chaosdorf/projector-controller-iot/README.md

# Chaosdorf Projector IOT

A simple IOT device to control our projector over serial. WIP.
