chaosdorf/projector-controller-iot/bracket/bracket.FCStd

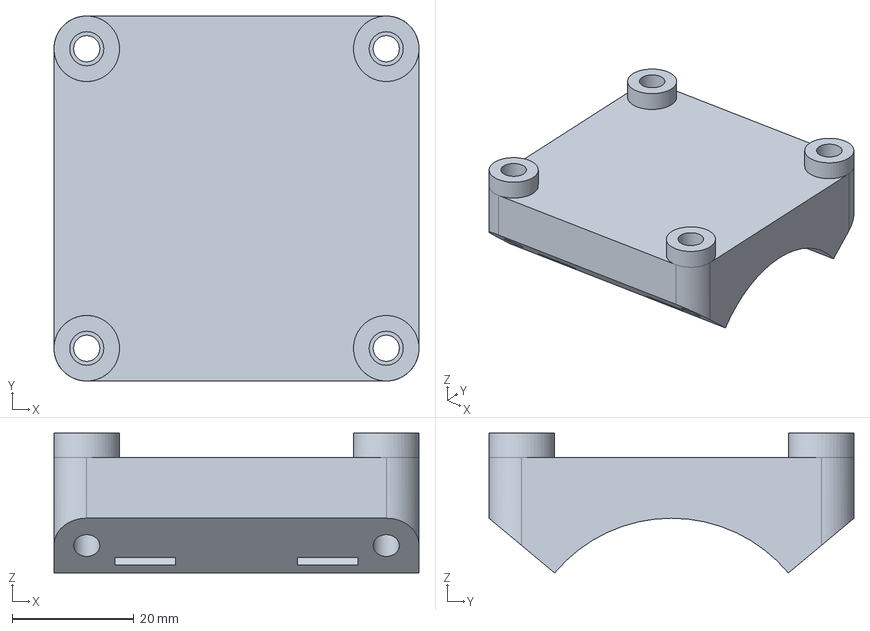
[picture p1: CAD file, 2025-09-13]
bracket/bracket.FCStd
60.0 x 60.0 x 23.0 mm
