chaosdorf/projector-controller-iot/(list of files, cad)

Other CAD files:
bracket/projector bracket.FCStd
bracket/bracket-bracket.step
bracket/bracket-bracket.stl
