chaosdorf/projector-controller-iot/pcb/projector-controller-iot.kicad_pcb

## KiCad design pcb/projector-controller-iot.kicad_pcb (2025-09-13)

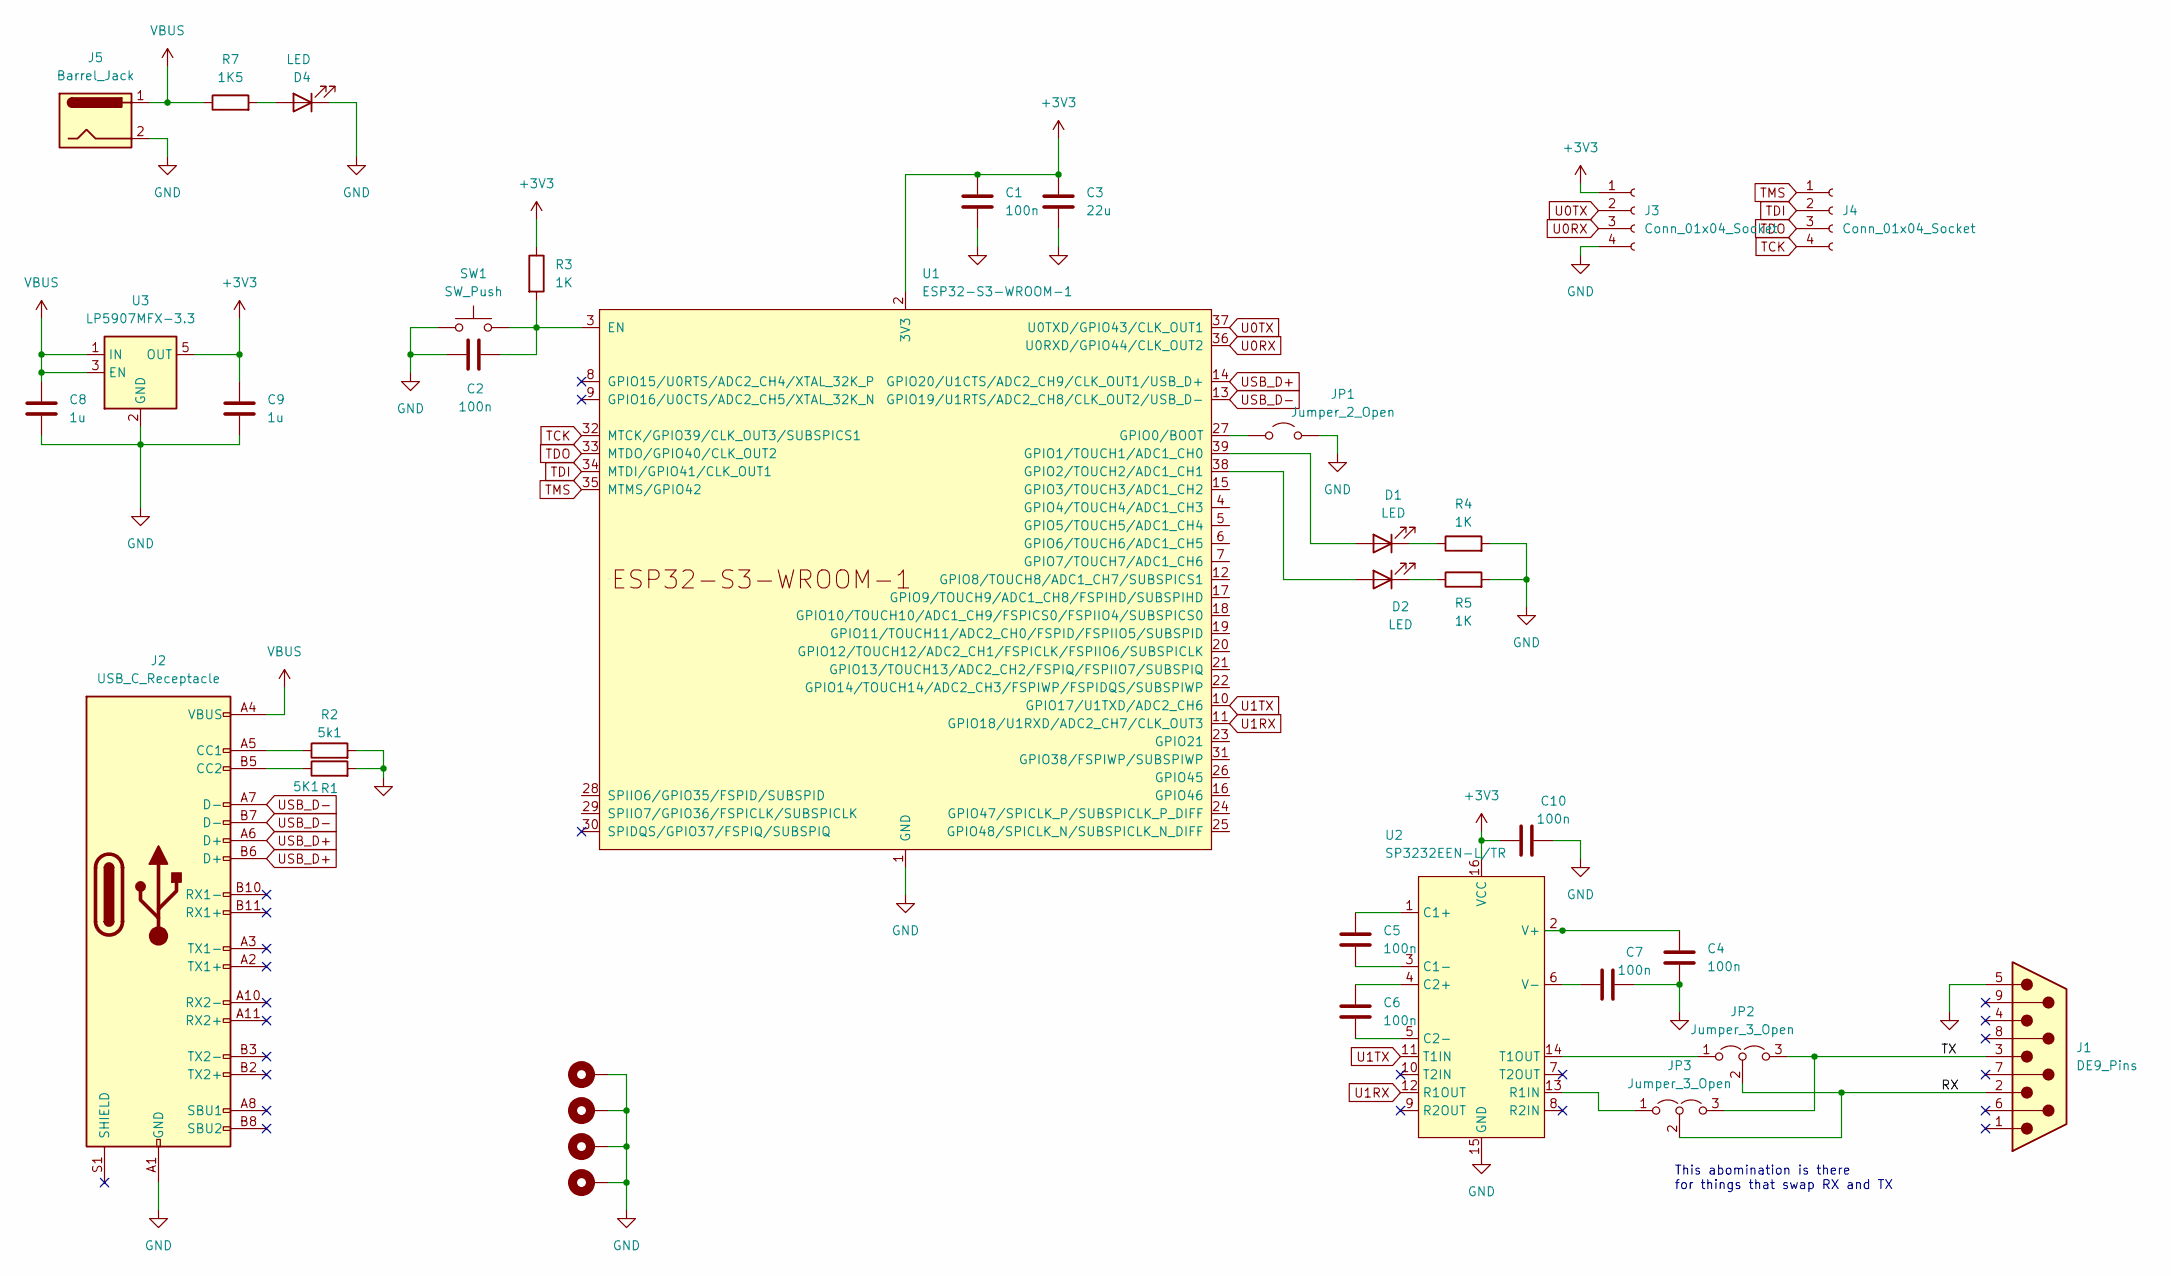
[picture p3: schematic projector-controller-iot.kicad_sch]

Parts:
C1, C2, C4, C5, C6, C7, C10: 100n; C_0603_1608Metric_Pad1.08x0.95mm_HandSolder
C3: 22u; C_0603_1608Metric_Pad1.08x0.95mm_HandSolder
C8, C9: 1u; C_0603_1608Metric_Pad1.08x0.95mm_HandSolder
D1, D2, D4: LED; LED_0603_1608Metric_Pad1.05x0.95mm_HandSolder_Triangle
H1, H2, H3, H4: MountingHole_Pad; MountingHole_4.5mm_Pad_Via
J1: DE9_Pins; DB9-TH_LD09P33E4GV00LF
J2: USB_C_Receptacle; USB_C_Receptacle_HRO_TYPE-C-31-M-12
J3, J4: Conn_01x04_Socket; JST_XH_B4B-XH-AM_1x04_P2.50mm_Vertical
J5: Barrel_Jack; DC-IN-TH_DC005
JP1: Jumper_2_Open; PinHeader_1x02_P2.54mm_Vertical
JP2, JP3: Jumper_3_Open
R1: 5K1; R_0603_1608Metric_Pad0.98x0.95mm_HandSolder
R2: 5k1; R_0603_1608Metric_Pad0.98x0.95mm_HandSolder
R3, R4, R5: 1K; R_0603_1608Metric_Pad0.98x0.95mm_HandSolder
R7: 1K5; R_0603_1608Metric_Pad0.98x0.95mm_HandSolder
SW1: SW_Push; SW-SMD_4P-L5.1-W5.1-P3.70-LS6.5-TL_H1.5
U1: ESP32-S3-WROOM-1
U2: SP3232EEN-L/TR; JEITA_SOIC-16_3.9x9.9mm_P1.27mm; LCSC Part C9378
U3: LP5907MFX-3.3; SOT-23-5

Connections:
+3V3: C1.1, C3.1, C9.1, C10.1, J3.1, R3.1, U1.2 (3V3), U2.16 (VCC), U3.5 (OUT)
/RX: J1.2, JP2.2 (C), JP3.1 (A), JP3.2 (C), U2.13 (R1IN)
/TX: J1.3, JP2.1 (A), JP2.3 (B), JP3.3 (B), U2.14 (T1OUT)
GND: C1.2, C2.1, C3.2, C4.2, C7.1, C8.2, C9.2, C10.2, D4.1 (K), H1.1, H2.1, H3.1, H4.1, J1.5, J2.A1 (GND), J2.A12 (GND), J2.B1 (GND), J2.B12 (GND), J3.4, J5.2, JP1.2 (B), R1.2, R2.2, R4.2, R5.2, SW1.1, U1.1 (GND), U1.40 (GND), U1.41 (GND), U2.15 (GND), U3.2 (GND)
unnamed: D1.2 (A), U1.39 (GPIO1/TOUCH1/ADC1_CH0)
unnamed: D1.1 (K), R4.1
unnamed: D2.2 (A), U1.38 (GPIO2/TOUCH2/ADC1_CH1)
unnamed: D2.1 (K), R5.1
unnamed: D4.2 (A), R7.2
unnamed: J2.A5 (CC1), R2.1
unnamed: J2.B5 (CC2), R1.1
unnamed: JP1.1 (A), U1.27 (GPIO0/BOOT)
unnamed: C2.2, R3.2, SW1.2, U1.3 (EN)
unnamed: C5.1, U2.1 (C1+)
unnamed: C5.2, U2.3 (C1-)
unnamed: C6.1, U2.4 (C2+)
unnamed: C6.2, U2.5 (C2-)
unnamed: C4.1, U2.2 (V+)
unnamed: C7.2, U2.6 (V-)
TCK: J4.4, U1.32 (MTCK/GPIO39/CLK_OUT3/SUBSPICS1)
TDI: J4.2, U1.34 (MTDI/GPIO41/CLK_OUT1)
TDO: J4.3, U1.33 (MTDO/GPIO40/CLK_OUT2)
TMS: J4.1, U1.35 (MTMS/GPIO42)
U0RX: J3.3, U1.36 (U0RXD/GPIO44/CLK_OUT2)
U0TX: J3.2, U1.37 (U0TXD/GPIO43/CLK_OUT1)
U1RX: U1.11 (GPIO18/U1RXD/ADC2_CH7/CLK_OUT3), U2.12 (R1OUT)
U1TX: U1.10 (GPIO17/U1TXD/ADC2_CH6), U2.11 (T1IN)
USB_D+: J2.A6 (D+), J2.B6 (D+), U1.14 (GPIO20/U1CTS/ADC2_CH9/CLK_OUT1/USB_D+)
USB_D-: J2.A7 (D-), J2.B7 (D-), U1.13 (GPIO19/U1RTS/ADC2_CH8/CLK_OUT2/USB_D-)
VBUS: C8.1, J2.A4 (VBUS), J2.A9 (VBUS), J2.B4 (VBUS), J2.B9 (VBUS), J5.1, R7.1, U3.1 (IN), U3.3 (EN)

Notes on the sheet:
This abomination is there for things that swap RX and TX

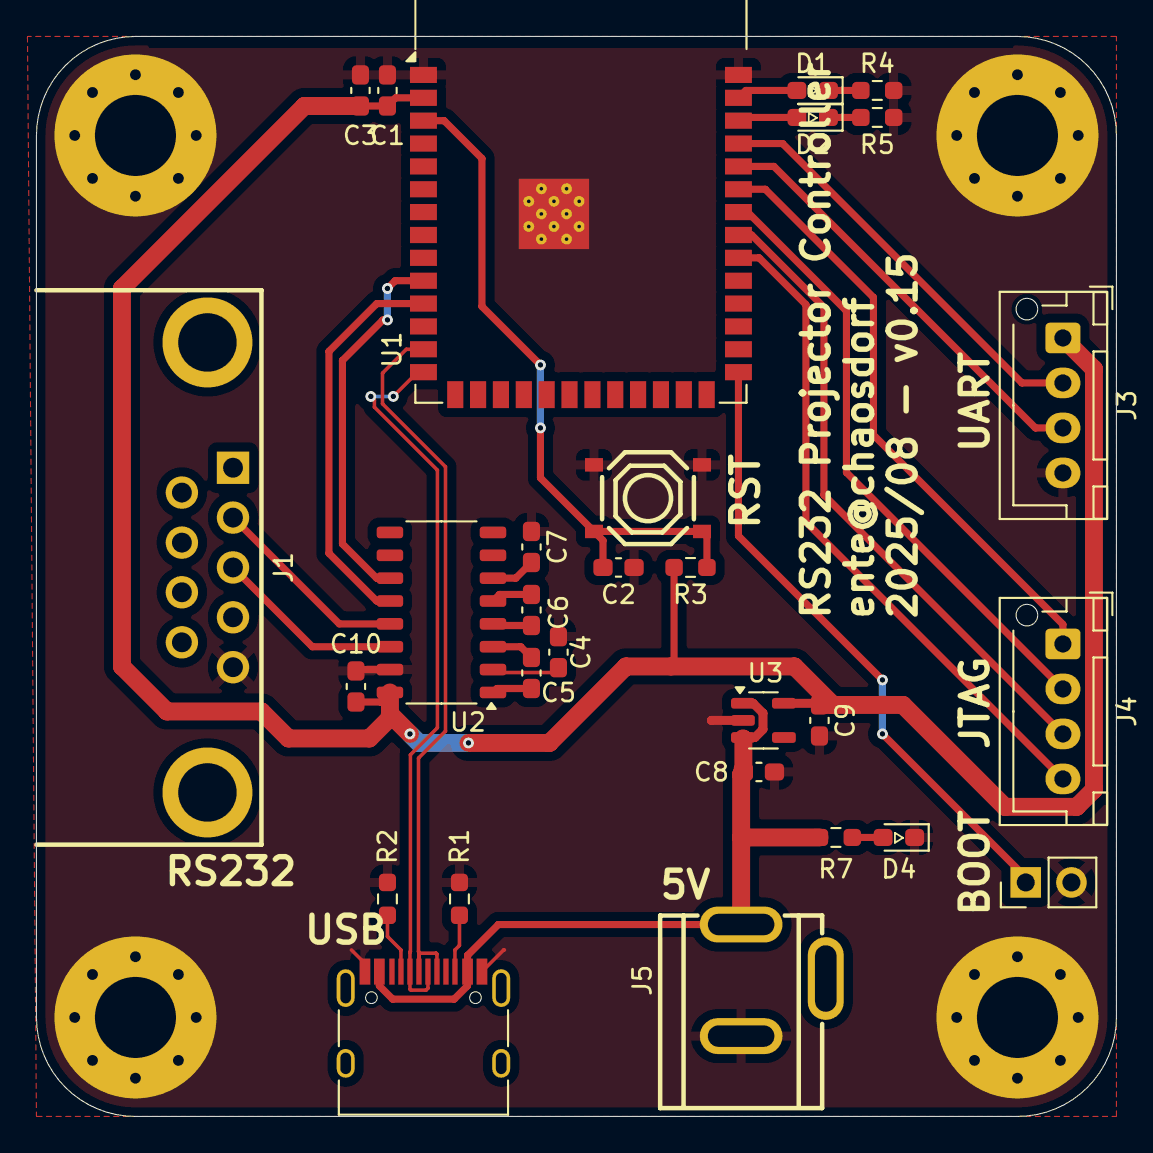
[picture p4: board projector-controller-iot.kicad_pcb from above]

Board: 2 copper layers, 60.0 x 60.0 mm, 33 parts (0 on the bottom side), 30 nets.
