chaosdorf/projector-controller-iot/firmware/build.rs

fn main() {
    dotenvy::dotenv().ok();

    let ssid = std::env::var("SSID").expect("SSID not set in .env or elsewhere");
    let password = std::env::var("PASSWORD").expect("PASSWORD not set in .env or elsewhere");
    let mqtt_broker =
        std::env::var("MQTT_BROKER").expect("MQTT_BROKER not set in .env or elsewhere");
    let defmt_log = std::env::var("DEFMT_LOG").unwrap_or_else(|_| "info".to_string());

    println!("cargo:rustc-env=SSID={}", ssid);
    println!("cargo:rustc-env=PASSWORD={}", password);
    println!("cargo:rustc-env=MQTT_BROKER={}", mqtt_broker);
    println!("cargo:rustc-env=DEFMT_LOG={}", defmt_log);

    linker_be_nice();
    // make sure linkall.x is the last linker script (otherwise might cause problems with flip-link)
    println!("cargo:rustc-link-arg=-Tlinkall.x");
}

fn linker_be_nice() {
    let args: Vec<String> = std::env::args().collect();
    if args.len() > 1 {
        let kind = &args[1];
        let what = &args[2];

        match kind.as_str() {
            "undefined-symbol" => match what.as_str() {
                "_defmt_timestamp" => {
                    eprintln!();
                    eprintln!("💡 `defmt` not found - make sure `defmt.x` is added as a linker script and you have included `use defmt_rtt as _;`");
                    eprintln!();
                }
                "_stack_start" => {
                    eprintln!();
                    eprintln!("💡 Is the linker script `linkall.x` missing?");
                    eprintln!();
                }
                "esp_wifi_preempt_enable"
                | "esp_wifi_preempt_yield_task"
                | "esp_wifi_preempt_task_create" => {
                    eprintln!();
                    eprintln!("💡 `esp-wifi` has no scheduler enabled. Make sure you have the `builtin-scheduler` feature enabled, or that you provide an external scheduler.");
                    eprintln!();
                }
                "embedded_test_linker_file_not_added_to_rustflags" => {
                    eprintln!();
                    eprintln!("💡 `embedded-test` not found - make sure `embedded-test.x` is added as a linker script for tests");
                    eprintln!();
                }
                _ => (),
            },
            // we don't have anything helpful for "missing-lib" yet
            _ => {
                std::process::exit(1);
            }
        }

        std::process::exit(0);
    }

    // println!(
    //     "cargo:rustc-link-arg=-Wl,--error-handling-script={}",
    //     std::env::current_exe().unwrap().display()
    // );
}
