chaosdorf/projector-controller-iot/firmware/src/net.rs

use core::net::Ipv4Addr;

use defmt::{debug, error, info};
use embassy_executor::Spawner;
use embassy_net::{tcp::TcpSocket, Runner, StackResources};
use embassy_time::{Duration, Timer};
use esp_alloc as _;
use esp_backtrace as _;
use esp_hal::timer::systimer::SystemTimer;
use esp_hal::{clock::CpuClock, rng::Rng, timer::timg::TimerGroup};
use esp_wifi::{
    init,
    wifi::{ClientConfiguration, Configuration, WifiController, WifiDevice, WifiEvent, WifiState},
    EspWifiController,
};

// When you are okay with using a nightly compiler it's better to use https://docs.rs/static_cell/2.1.0/static_cell/macro.make_static.html
macro_rules! mk_static {
    ($t:ty,$val:expr) => {{
        static STATIC_CELL: static_cell::StaticCell<$t> = static_cell::StaticCell::new();
        #[deny(unused_attributes)]
        let x = STATIC_CELL.uninit().write(($val));
        x
    }};
}

const SSID: &str = env!("SSID");
const PASSWORD: &str = env!("PASSWORD");

// connects to the wifi and maintains the connection
#[embassy_executor::task]
pub async fn connection(mut controller: WifiController<'static>) {
    info!("start connection task");
    // info!("Device capabilities: {:?}", controller.capabilities());
    loop {
        match esp_wifi::wifi::wifi_state() {
            WifiState::StaConnected => {
                // wait until we're no longer connected
                controller.wait_for_event(WifiEvent::StaDisconnected).await;
                Timer::after(Duration::from_millis(5000)).await
            }
            _ => {}
        }
        if !matches!(controller.is_started(), Ok(true)) {
            let client_config = Configuration::Client(ClientConfiguration {
                ssid: SSID.into(),
                password: PASSWORD.into(),
                ..Default::default()
            });
            controller.set_configuration(&client_config).unwrap();
            info!("Starting wifi");
            controller.start_async().await.unwrap();
            info!("Wifi started!");

            info!("Scan");
            let result = controller.scan_n_async(10).await.unwrap();
            for ap in result {
                debug!("{:?}", defmt::Debug2Format(&ap));
            }
        }
        info!("About to connect...");

        match controller.connect_async().await {
            Ok(_) => info!("Wifi connected!"),
            Err(e) => {
                error!("Failed to connect to wifi: {}", defmt::Debug2Format(&e));
                Timer::after(Duration::from_millis(5000)).await
            }
        }
    }
}

#[embassy_executor::task]
pub async fn net_task(mut runner: Runner<'static, WifiDevice<'static>>) {
    runner.run().await
}
