chaosdorf/projector-controller-iot/(commit log)

2025-08-29 version where the esp sticks out
    [projector-controller-iot.kicad_pcb, projector-controller-iot.kicad_sch]
2025-08-30 make the esp not stick out
    [bom.csv, designators.csv, positions.csv, projector-controller-iot.kicad_pcb, projector-controller-iot.kicad_sch]
2025-09-03 make fanout make sense
    [projector-controller-iot.kicad_pcb, projector-controller-iot.kicad_sch]
2025-09-08 add gitignore
    [projector-controller-iot.kicad_pcb]
2025-09-08 esp32c3 gets ip address
2025-09-13 Bro idk
    [projector-controller-iot.kicad_pcb, projector-controller-iot.kicad_sch]
2025-09-13 Add bracket
    [bracket-bracket.step, bracket-bracket.stl, bracket.FCStd, projector bracket.FCStd]
2025-09-13 Make home assistant work for power
2025-09-18 Send initial power state over MQTT
